MacAnalog/dn-002-tx-driver-pam4-ihp130/report/figs/round4/fig_balance.pdf

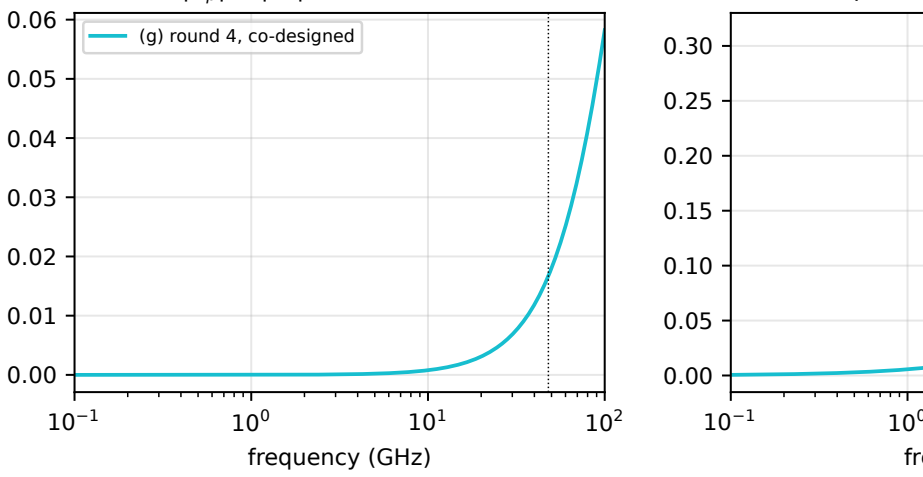
[picture p7: figure]
frequency (GHz); (g) round 4, co-designed

|Vp| − |Vn| (dB), MSB drive

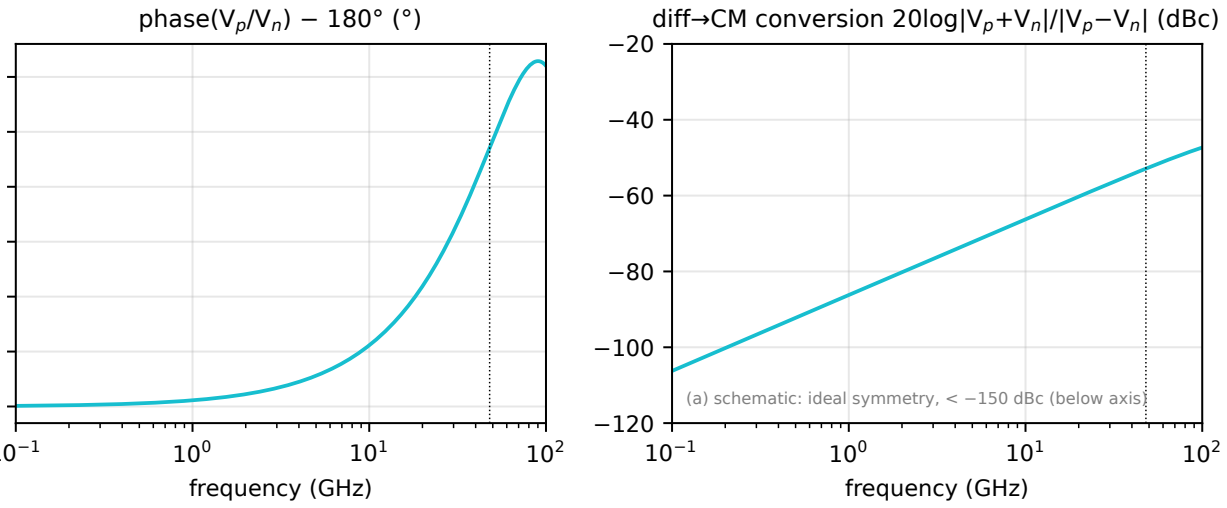
[picture p8: figure]
frequency (GHz); phase(Vp/Vn) − 180° (°); diff→CM conversion 20log|Vp+Vn|/|Vp−Vn| (dBc)

0 | 10
1 | 10
2
frequency (GHz)
(a) schematic: ideal symmetry, < −150 dBc (below axis)
