MacAnalog/dn-002-tx-driver-pam4-ihp130/report/figs/round4/fig_dc.pdf

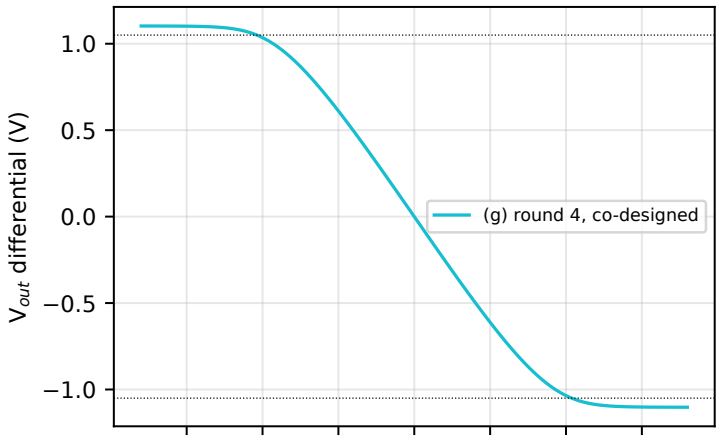
[picture p9: figure]
Vout differential (V); (g) round 4, co-designed

−0.75 −0.50 −0.25 0.00 0.25 0.50 0.75 differential source EMF, both ports (V)

DC transfer (swing spec ≥ 2.1 Vpp = ±1.05 V)
