MacAnalog/dn-002-tx-driver-pam4-ihp130/report/figs/round4/fig_layouts.pdf

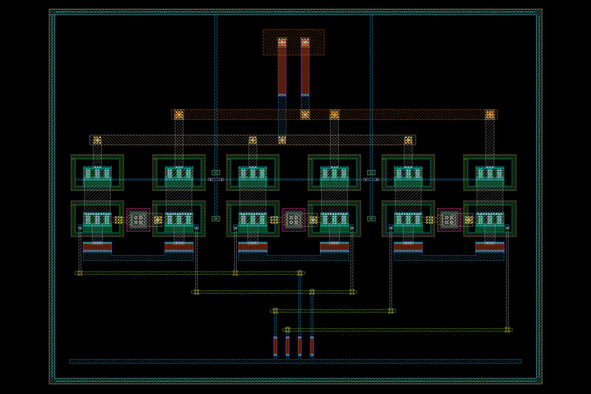
[picture p10: page 1]

−40 | −20 | 0 | 20 | 40
| | x (µm)

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
y (µm)

(g) co-design round 4 accepted point (r4_s10/run_29: reviewer-margin hinges + vcc_trim/rb_off options) 97.1 × 73.8 µm = 7166 µm² S11 -10.17 / S22 -10.25 dB 175 mW
