MacAnalog/dn-002-tx-driver-pam4-ihp130/layout/codesign/before_after_r4.pdf

−40 | −20 | 0 | 20 | 40
| | x (um)

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
## y (um)

## before: round-3 record (r3_s12 run_26, FINAL_LAYOUT), kpex halo 8

S11 -10.16 dB S22 -10.28 dB MSB 8.36 dB LSB 2.38 dB BW 61.1 GHz swing 2.11 Vpp 167 mW 7268 um2

−40 | −20 | 0 | 20 | 40
| | x (um)

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
## y (um)

moved knobs: gap_x 5.65->5.66, row_gap 1.91->1.96, cell_gap 4.21->4.12, re_ohm 3.09->3.24, rc_ohm 51.77->52.08, rb_ohm 48.32->48.01, cdeg_ff 16.84->17.24, re_w 5.66->5.56, rc_w 1.51->1.52, rb_w 0.68->0.64, w_out 1.68->1.61, in_off 2.18->2.16, in_bus_gap 3.26->3.12, sub_off 1.33->1.3, out_off 2.06->1.88, out_w 1.97->1.94, out_gap 3.18->3.05, in_bus_lvl 0->3, rc_sep 4.48->4.55, rc_gap 2.87->2.82, vcc_trim 0->1, rb_off 0->-9.23, stack_w 1.47->1.43

## after: round-4 accepted (r4_s10 run_29, R4_LAYOUT), kpex halo 8

S11 -10.24 dB S22 -10.25 dB MSB 8.37 dB LSB 2.39 dB BW 61.5 GHz swing 2.21 Vpp 175 mW 7166 um2

output buses: bus_trim 1->1, out_split 1->1, out_gap 3.18->3.05
