MacAnalog/dn-002-tx-driver-pam4-ihp130/report/figs/fig_layout_b_vs_d.pdf

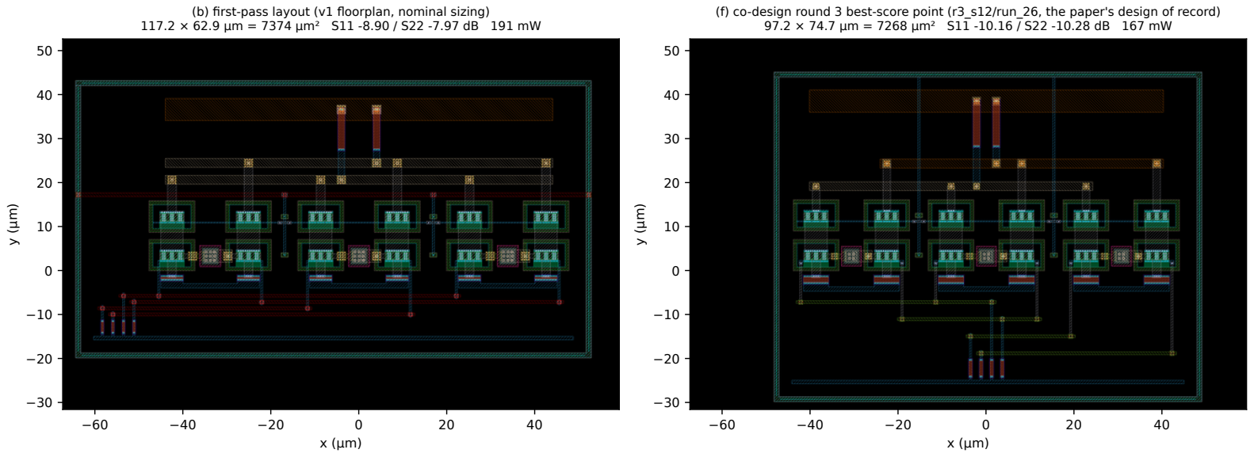
[picture p11: page 1]

−60 | −40 | −20 | 0 | 20 | 40
| | | x (µm)

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
y (µm)

(b) first-pass layout (v1 floorplan, nominal sizing)
117.2 × 62.9 µm = 7374 µm² S11 -8.90 / S22 -7.97 dB 191 mW
−60 | −40 | −20 | 0 | 20 | 40
| | | x (µm)

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
y (µm)

(f) co-design round 3 best-score point (r3_s12/run_26, the paper's design of record) 97.2 × 74.7 µm = 7268 µm² S11 -10.16 / S22 -10.28 dB 167 mW
