MacAnalog/dn-002-tx-driver-pam4-ihp130/report/figs/round4/fig_eye.pdf

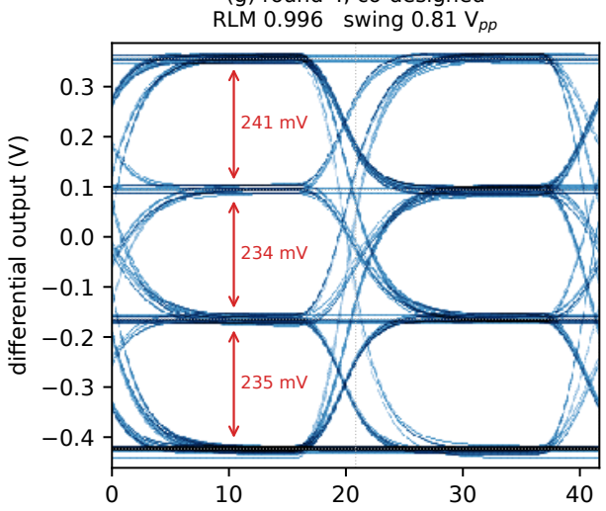
[picture p12: figure]
fferential output (V); RLM 0.996 swing 0.81 Vpp

time (ps) — 2 UI, eye centred at 0.5 UI

(g) round 4, co-designed

48 GBd PAM-4 eye — 200 mVpp input, 4 ps edges, seed-7 MSB/LSB streams; post-layout tiers on the kpex 2.5D CC extraction
