MacAnalog/dn-002-tx-driver-pam4-ihp130/report/figs/round4/fig_eye_paper.pdf

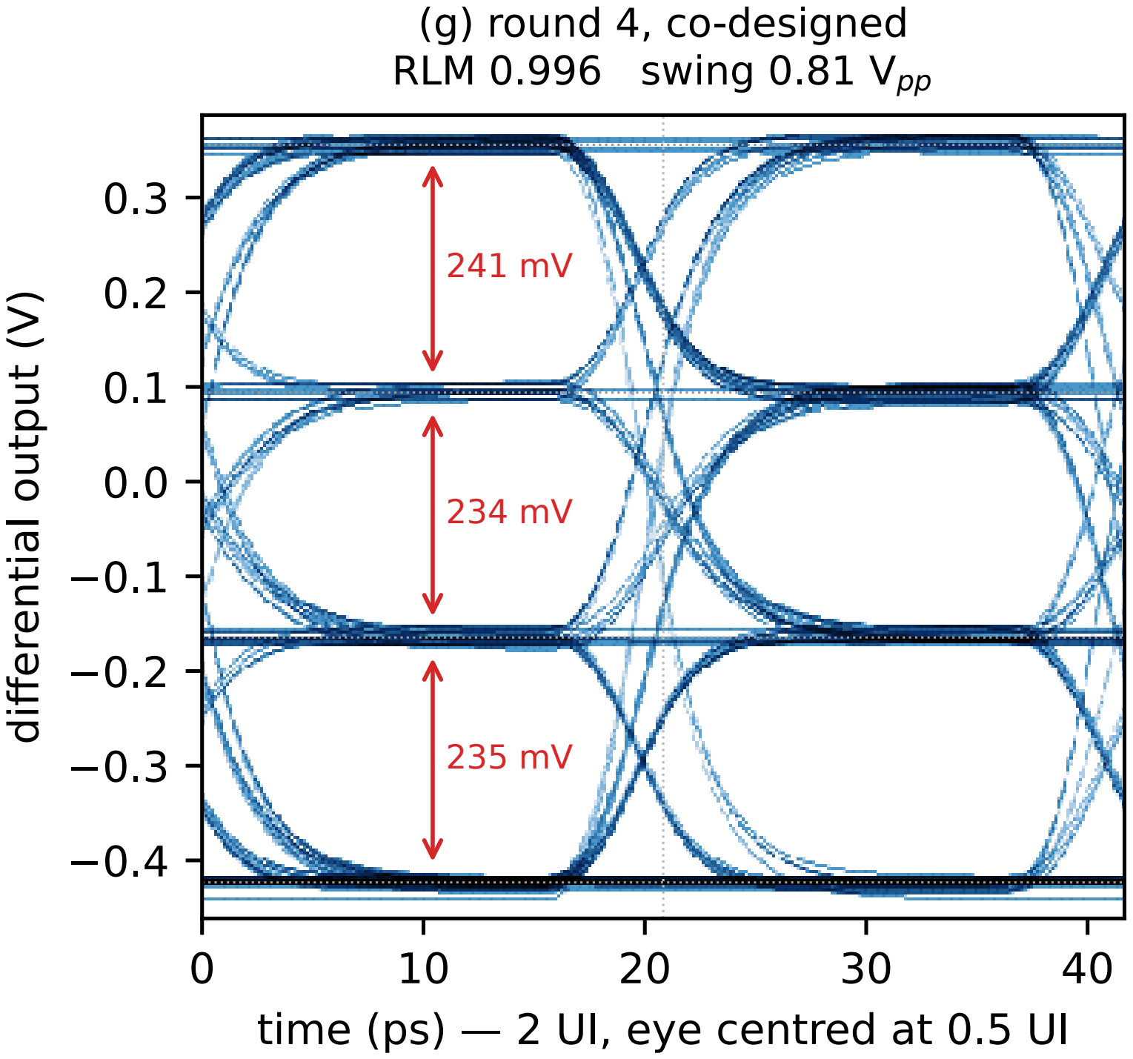
[picture p13: page 1]

0 | 10 | 20 | 30 | 40
time (ps) — 2 UI, eye centred at 0.5 UI

−0.4

−0.3

−0.2

−0.1

0.0

0.1

0.2

0.3

di

fferential output (V)

241 mV

234 mV

235 mV

(g) round 4, co-designed
RLM 0.996 swing 0.81 Vpp
