MacAnalog/dn-002-tx-driver-pam4-ihp130/report/figs/round4/fig_sparams.pdf

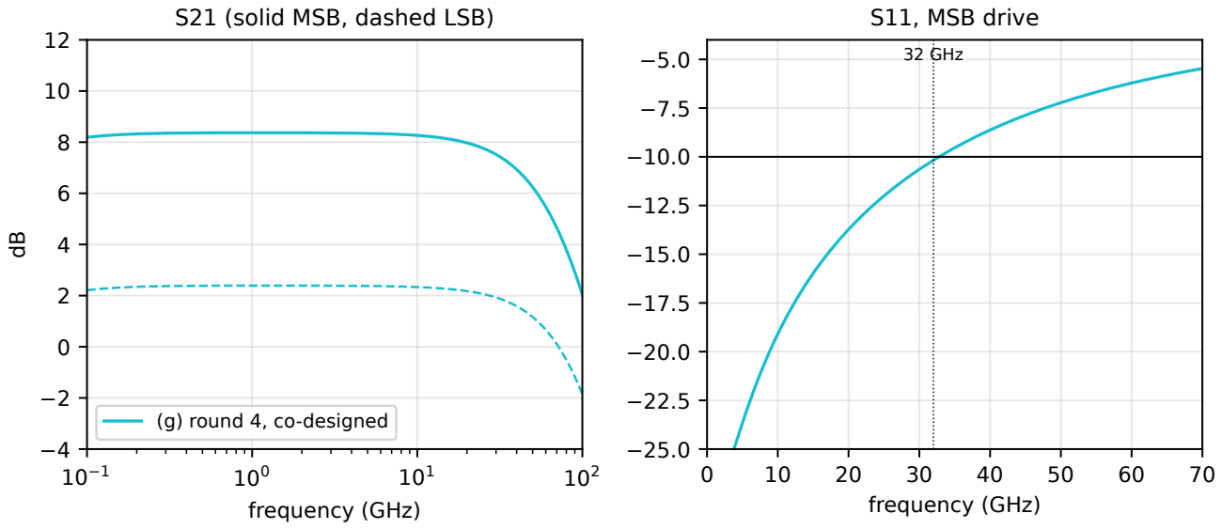
[picture p14: figure]
frequency (GHz); S21 (solid MSB, dashed LSB); (g) round 4, co-designed; 32 GHz; S11, MSB drive
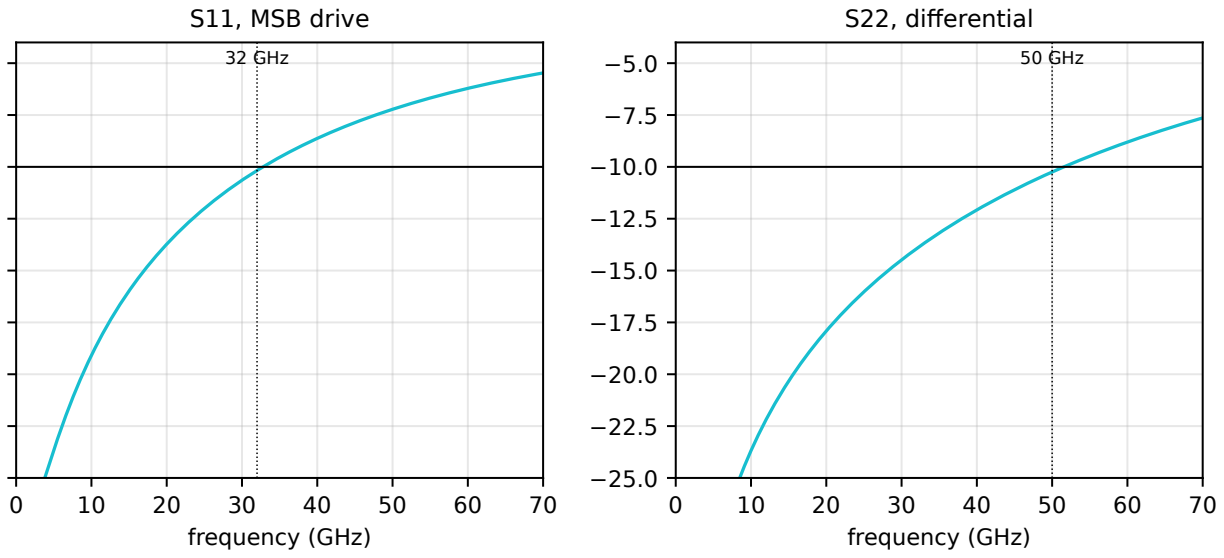
[picture p15: figure]
frequency (GHz); 50 GHz; S22, differential
