MacAnalog/dn-002-tx-driver-pam4-ihp130/layout/codesign/before_after_r4.png

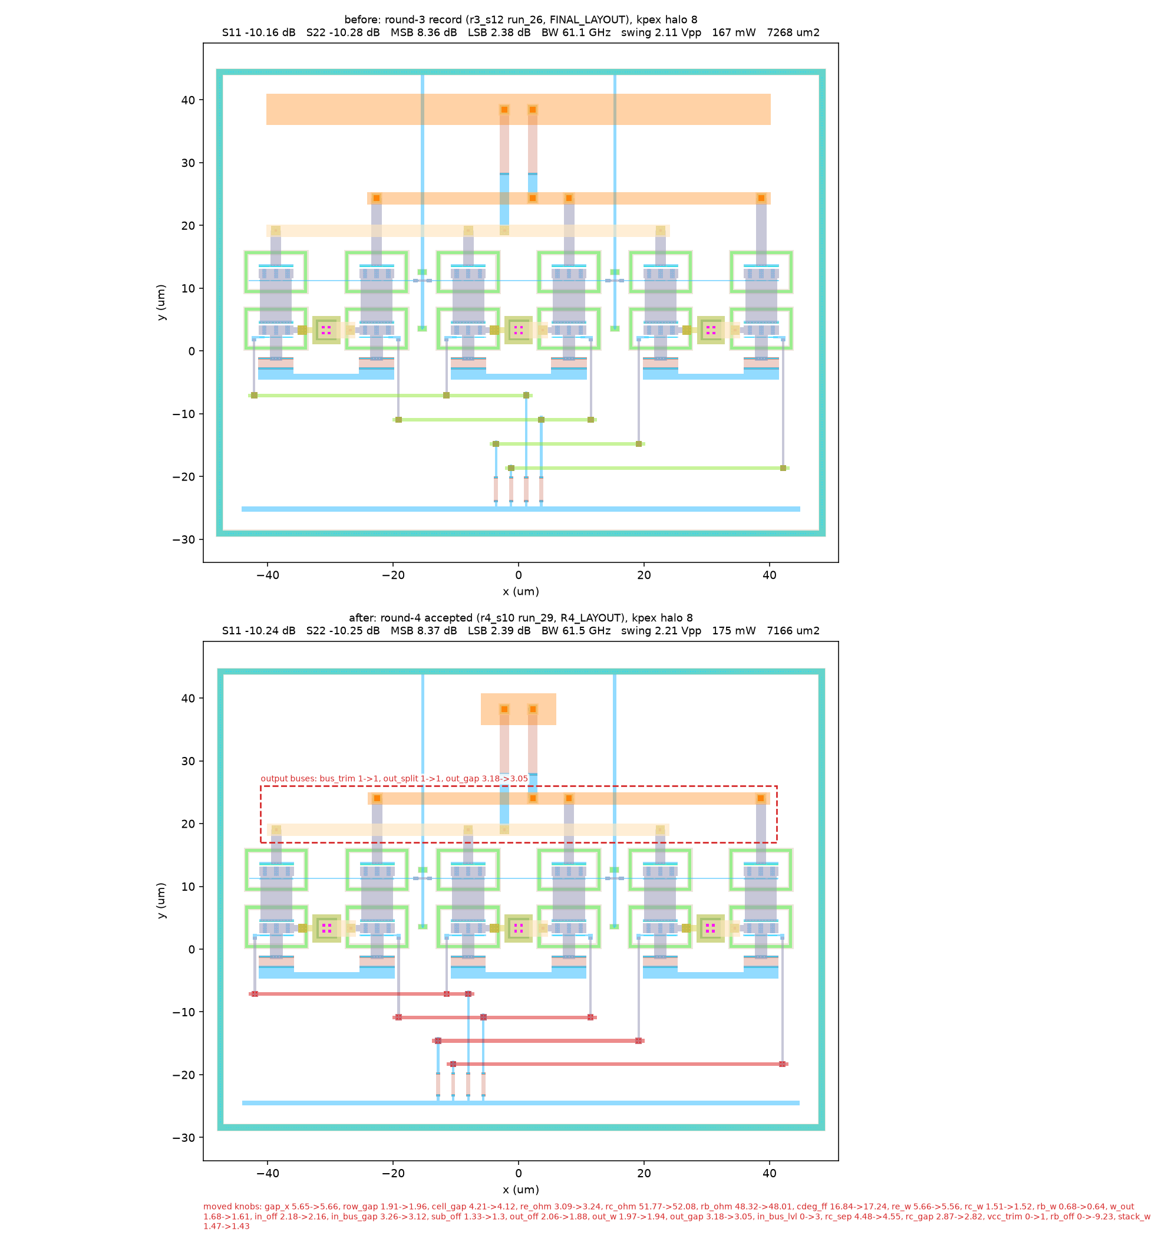
layout/codesign/before_after_r4.png
