MacAnalog/dn-002-tx-driver-pam4-ihp130/layout/codesign/pam4_layout_annotated_r4.png

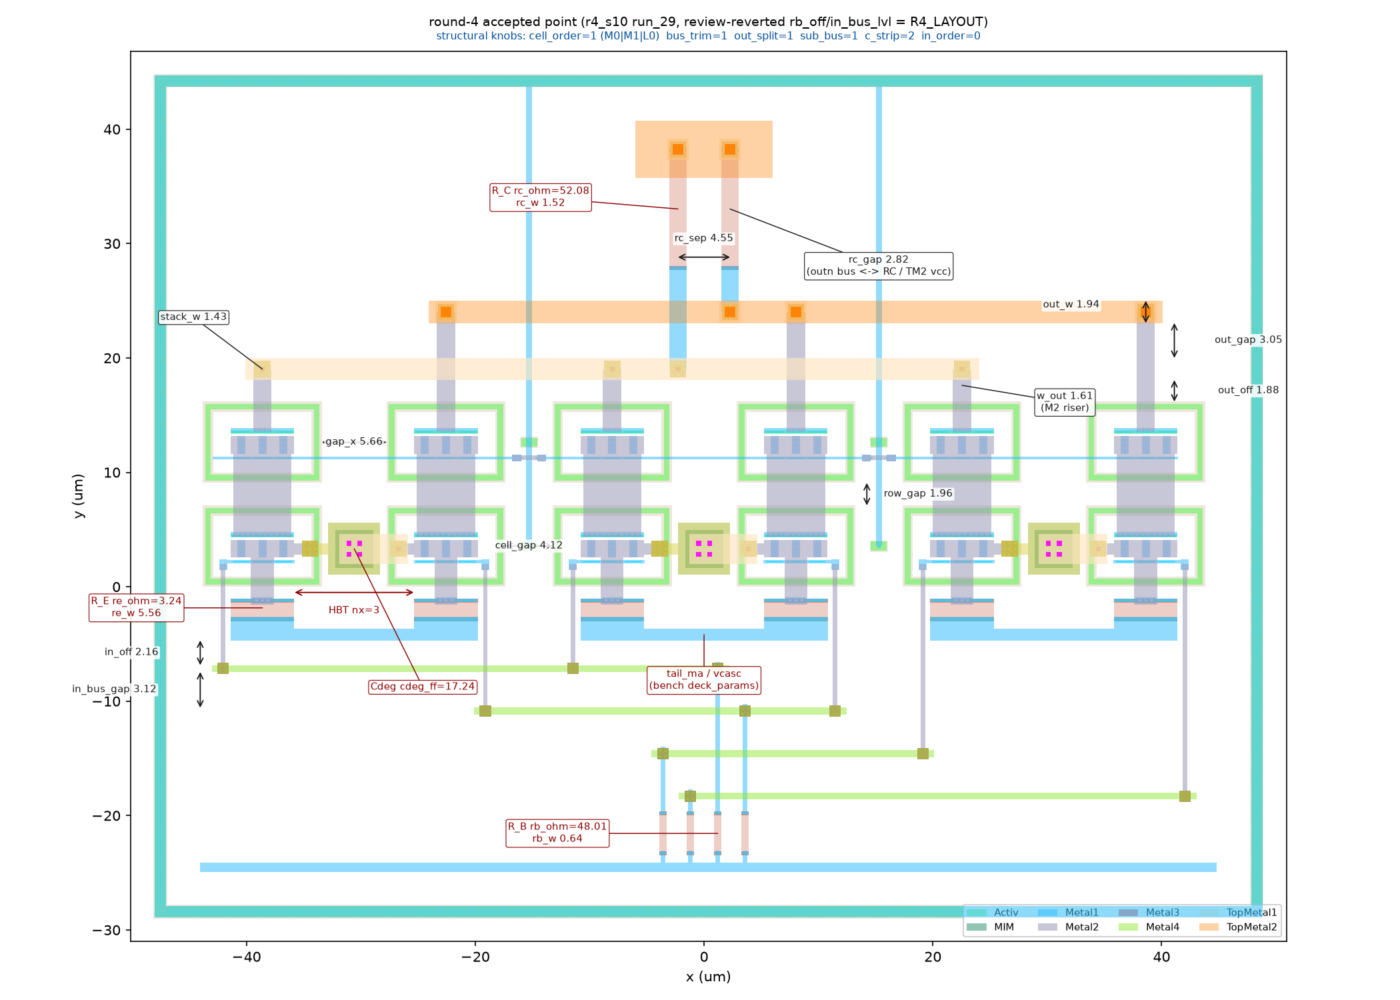
layout/codesign/pam4_layout_annotated_r4.png
