MacAnalog/dn-002-tx-driver-pam4-ihp130/report/figs/round4/fig_balance.png

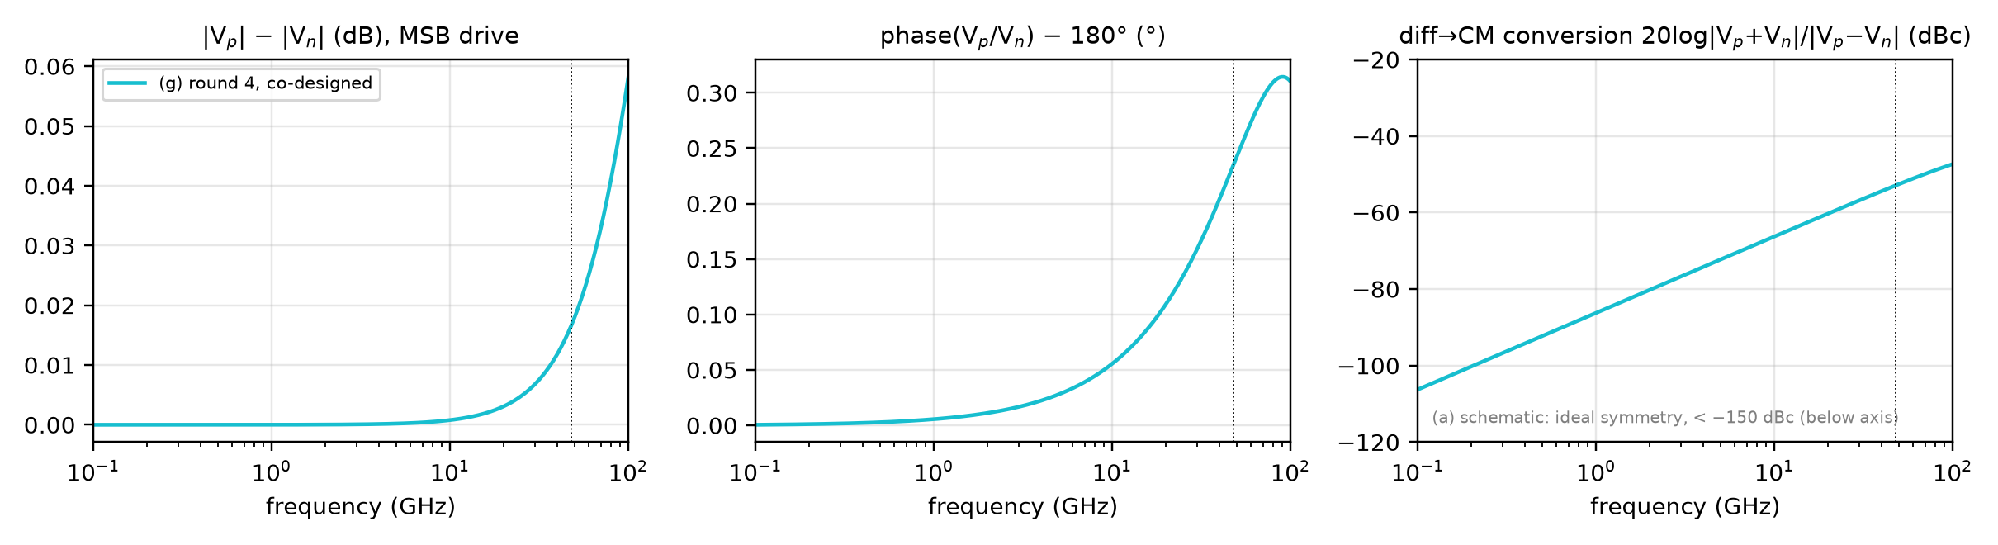
report/figs/round4/fig_balance.png
