MacAnalog/dn-002-tx-driver-pam4-ihp130/report/figs/round4/fig_layout_f_vs_g.png

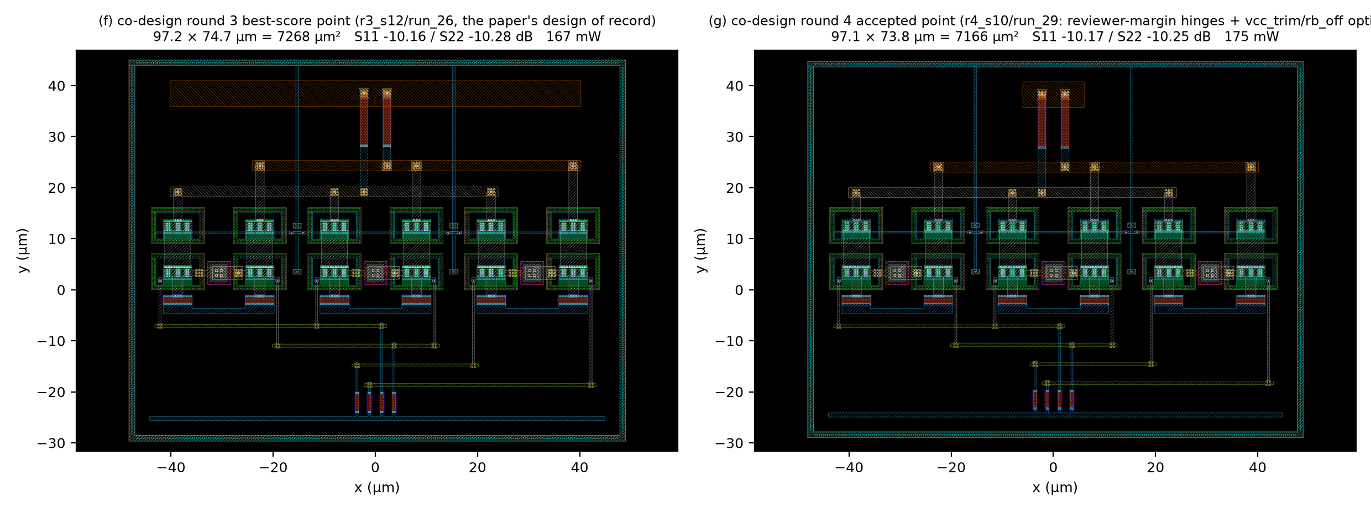
report/figs/round4/fig_layout_f_vs_g.png
