MacAnalog/dn-002-tx-driver-pam4-ihp130/layout/codesign/results/r4/verification.md

# Post-layout verification of the round-4 point (`R4_LAYOUT` = r4_s10/run_29 with `rb_off`/`in_bus_lvl` reverted)

Measured on the halo-8 extraction of the accepted point (`runs/rm_r4_rb0_lvl4`, the
report instrument; `accepted.gds` / `accepted_post.spice` / `accepted_summary.json` here
are that trial) with the reviewer-evidence harness (`~/sx-scratch/pam4-driver-reviewer-evidence/`
on the research server — NOT in this repo; its `config/pvt.yaml` + `config/mc.yaml` are the
corner grid / MC sets, `harness.py` wraps this repo's own `measure_post.measure` + `driver_lib`
with the platform's `apply_corner_to_deck`; it has to run with THIS repo's `.venv` (gdsfactory)
plus `dacite`; moving it into the repo is a follow-up for the owner). Same corner grid, MC
sets, seeds and instrument as the record's pack. The record's own sweep is the comparison
column; the search leader `run_29` as searched (before the review revert, see README
"Round 4") is kept as the middle column so the cost of the revert at the corners is visible.

## PVT — worst corner per spec, record vs run_29-as-searched vs round 4

/bin/bash: line 59: ../../.venv/bin/python: No such file or directory

## PVT — full tables (round 4)

Corners run: **36/36 converged**  (3 process x 3 VCC x 4 temperature, instrument = the record's own `layout/codesign/measure_post.measure`).

### Nominal cross-check (tt / 4.0 V / 27 C vs the paper's Round-3 column; `paper` = the record)

| metric | paper | this run | delta |
|---|---:|---:|---:|
| s11 (dB) | -10.157 | -10.18 | -0.01809 |
| s11_edge_ghz (GHz) | 32.71 | 32.79 | +0.08052 |
| s22 (dB) | -10.28 | -10.25 | +0.03344 |
| s22_edge_ghz (GHz) | 51.77 | 51.56 | -0.2112 |
| lsb_gain (dB) | 2.38 | 2.393 | +0.01303 |
| msb_gain (dB) | 8.36 | 8.37 | +0.009857 |
| bw (GHz) | 61.1 | 61.28 | +0.1821 |
| swing (Vpp) | 2.106 | 2.205 | +0.09921 |
| power (mW) | 167.164 | 175 | +7.847 |
| pn_gain_imb_db (dB) | 0.0167 | 0.0166 | -9.764e-05 |
| pn_phase_imb_deg (deg) | 0.2425 | 0.247 | +0.004494 |
| cm_leak_dbc (dBc) | -52.65 | -52.53 | +0.1231 |

Every printed metric reproduces; the harness measures the same thing the paper does.

### Worst corner per spec

| metric | spec | worst value | worst corner | margin | verdict |
|---|---:|---:|---|---:|:--|
| s11 | <= -10 dB | -8.735 | `ss_3.8V_125C` | -1.27 | **FAIL** |
| s22 | <= -10 dB | -6.372 | `ss_3.8V_125C` | -3.63 | **FAIL** |
| pn_gain_imb_db | <= 0.05 dB | 0.02686 | `ss_3.8V_125C` | +0.0231 | PASS |
| pn_phase_imb_deg | <= 1 deg | 0.2718 | `tt_4.2V_125C` | +0.728 | PASS |
| cm_leak_dbc | <= -40 dBc | -51.29 | `ss_4.2V_125C` | +11.3 | PASS |
| power | <= 192 mW | 184.4 | `ff_4.2V_-40C` | +7.62 | PASS |
| ic_ma_per_finger | <= 3 mA | 2.442 | `tt_3.8V_-40C` | +0.558 | PASS |
| msb_gain | >= 8.2 dB | 6.458 | `ss_4.2V_-40C` | -1.74 | **FAIL** |
| lsb_gain | >= 2.2 dB | 0.4735 | `ss_4.2V_-40C` | -1.73 | **FAIL** |
| weight | >= 5 dB | 5.9 | `ss_4.2V_125C` | +0.9 | PASS |
| bw | >= 50 GHz | 44.04 | `ss_3.8V_125C` | -5.96 | **FAIL** |
| swing | >= 2.1 Vpp | 1.83 | `ff_3.8V_-40C` | -0.27 | **FAIL** |

**6/36 corners meet every spec.**

**7 corners have an INCOMPLETE DC sweep** — ngspice stopped the sweep at a non-converging point and the bench accepted the partial file, so their `swing` is a measurement artifact, not a design failure, and is excluded from the verdicts above:

| corner | sweep points | expected | reported swing (invalid) |
|---|---:|---:|---:|
| `ff_3.8V_85C` | 21 | 121 | 0.009147 |
| `ff_3.8V_125C` | 58 | 121 | 0.9892 |
| `ff_4V_125C` | 38 | 121 | 0.2468 |
| `ff_4.2V_85C` | 44 | 121 | 0.4138 |
| `ff_4.2V_125C` | 62 | 121 | 1.226 |
| `ss_3.8V_125C` | 117 | 121 | 2.209 |
| `ss_4.2V_85C` | 94 | 121 | 2.319 |

Corners that violate at least one spec:

| corner | s11 | s22 | pn_gain_imb_db | pn_phase_imb_deg | cm_leak_dbc | power | ic_ma_per_finger | msb_gain | lsb_gain | weight | bw | swing |
|---|---:|---:|---:|---:|---:|---:|---:|---:|---:|---:|---:|---:|
| `tt_3.8V_-40C` | -10.19 | -10.78 | 0.01331 | 0.2211 | -53.63 | 166.6 | 2.442 | **6.841** | **0.8432** | 5.998 | 71.18 | **1.96** |
| `tt_3.8V_85C` | **-9.644** | **-8.694** | 0.02026 | 0.2572 | -51.92 | 165.9 | 2.442 | 9.172 | 3.213 | 5.958 | 54.32 | 2.23 |
| `tt_3.8V_125C` | **-9.194** | **-7.554** | 0.02306 | 0.2573 | -51.65 | 165.7 | 2.442 | 9.538 | 3.592 | 5.946 | 50.08 | 2.241 |
| `tt_4V_-40C` | -10.19 | -10.89 | 0.01317 | 0.2217 | -53.63 | 175.4 | 2.442 | **6.84** | **0.8419** | 5.998 | 71.5 | **1.969** |
| `tt_4V_85C` | **-9.654** | **-9.109** | 0.01949 | 0.262 | -51.86 | 174.7 | 2.442 | 9.169 | 3.211 | 5.958 | 55.29 | 2.359 |
| `tt_4V_125C` | **-9.218** | **-8.222** | 0.02162 | 0.268 | -51.51 | 174.4 | 2.442 | 9.536 | 3.59 | 5.946 | 51.89 | 2.422 |
| `tt_4.2V_-40C` | -10.19 | -10.96 | 0.01307 | 0.2221 | -53.62 | 184.2 | 2.442 | **6.838** | **0.8406** | 5.998 | 71.74 | **1.969** |
| `tt_4.2V_85C` | **-9.657** | **-9.278** | 0.01918 | 0.2638 | -51.84 | 183.4 | 2.442 | 9.167 | 3.209 | 5.958 | 55.66 | 2.381 |
| `tt_4.2V_125C` | **-9.227** | **-8.498** | 0.02103 | 0.2718 | -51.47 | 183.1 | 2.442 | 9.533 | 3.587 | 5.946 | 52.52 | 2.477 |
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

## Mismatch Monte Carlo

### Where each spread comes from

`pair_only` mismatches the six differential-pair HBTs; `all_devices` adds the resistors and capacitors. Same seeds, same count, so the ratio of sigmas attributes each spread.

| metric | sigma, pair only | sigma, all devices | ratio | dominated by |
|---|---:|---:|---:|---|
| offset_mv (mV) | 33.5 | 33.6 | 1.00x | the differential pair |
| pn_gain_imb_db (dB) | 0.00287 | 0.0265 | 9.22x | the passives (R / C) |
| pn_phase_imb_deg (deg) | 0.167 | 0.377 | 2.26x | both, comparably |
| cm_leak_dbc (dBc) | 4.1 | 6.77 | 1.65x | both, comparably |
| msb_gain (dB) | 0.246 | 0.247 | 1.01x | the differential pair |
| lsb_gain (dB) | 0.358 | 0.359 | 1.00x | the differential pair |
| swing (Vpp) | 0.000447 | 0.00348 | 7.77x | the passives (R / C) |
| power (mW) | 0.012 | 0.0171 | 1.43x | both, comparably |
| bw (GHz) | 1.05 | 1.1 | 1.05x | the differential pair |
| s11 (dB) | 0.247 | 0.249 | 1.01x | the differential pair |
| s22 (dB) | 0.0104 | 0.17 | 16.32x | the passives (R / C) |

### `all_devices` — 200/200 samples converged

| metric | nominal | mean | sigma | min | max | 3-sigma band |
|---|---:|---:|---:|---:|---:|---|
| offset_mv (mV) | -0.0002166 | 0.6847 | 33.6 | -86.99 | 121.1 | -100 .. 101.4 |
| pn_gain_imb_db (dB) | 0.0166 | 0.03912 | 0.0265 | 0.001203 | 0.1417 | -0.04023 .. 0.1185 |
| pn_phase_imb_deg (deg) | 0.247 | 0.4702 | 0.377 | 0.006405 | 2 | -0.6621 .. 1.602 |
| cm_leak_dbc (dBc) | -52.53 | -48.54 | 6.77 | -66.87 | -34.28 | -68.85 .. -28.22 |
| msb_gain (dB) | 8.37 | 8.331 | 0.247 | 7.684 | 8.924 | 7.589 .. 9.074 |
| lsb_gain (dB) | 2.393 | 2.37 | 0.359 | 1.474 | 3.291 | 1.293 .. 3.446 |
| swing (Vpp) | 2.205 | 2.205 | 0.00348 | 2.196 | 2.213 | 2.194 .. 2.215 |
| power (mW) | 175 | 175 | 0.0171 | 175 | 175 | 175 .. 175.1 |
| bw (GHz) | 61.28 | 61.31 | 1.1 | 58.49 | 63.82 | 58 .. 64.61 |
| s11 (dB) | -10.18 | -10.19 | 0.249 | -10.83 | -9.601 | -10.94 .. -9.442 |
| s22 (dB) | -10.25 | -10.24 | 0.17 | -10.83 | -9.817 | -10.75 .. -9.733 |
Samples outside the acceptance box:

| metric | spec | samples failing | rate |
|---|---:|---:|---:|
| s11 | <= -10 dB | 48/200 | 24.0 % |
| s22 | <= -10 dB | 18/200 | 9.0 % |
| pn_gain_imb_db | <= 0.05 dB | 56/200 | 28.0 % |
| pn_phase_imb_deg | <= 1 deg | 23/200 | 11.5 % |
| cm_leak_dbc | <= -40 dBc | 16/200 | 8.0 % |
| msb_gain | >= 8.2 dB | 58/200 | 29.0 % |
| lsb_gain | >= 2.2 dB | 66/200 | 33.0 % |

### `pair_only` — 200/200 samples converged

| metric | nominal | mean | sigma | min | max | 3-sigma band |
|---|---:|---:|---:|---:|---:|---|
| offset_mv (mV) | -0.0002166 | 0.8597 | 33.5 | -85.98 | 119.9 | -99.58 .. 101.3 |
| pn_gain_imb_db (dB) | 0.0166 | 0.01646 | 0.00287 | 0.009488 | 0.02425 | 0.007853 .. 0.02507 |
| pn_phase_imb_deg (deg) | 0.247 | 0.2739 | 0.167 | 0.0135 | 0.8949 | -0.2276 .. 0.7753 |
| cm_leak_dbc (dBc) | -52.53 | -52.38 | 4.1 | -60.89 | -42.1 | -64.68 .. -40.08 |
| msb_gain (dB) | 8.37 | 8.33 | 0.246 | 7.675 | 8.933 | 7.594 .. 9.067 |
| lsb_gain (dB) | 2.393 | 2.369 | 0.358 | 1.449 | 3.293 | 1.293 .. 3.444 |
| swing (Vpp) | 2.205 | 2.205 | 0.000447 | 2.204 | 2.206 | 2.204 .. 2.206 |
| power (mW) | 175 | 175 | 0.012 | 175 | 175 | 175 .. 175 |
| bw (GHz) | 61.28 | 61.35 | 1.05 | 58.63 | 64.04 | 58.2 .. 64.5 |
| s11 (dB) | -10.18 | -10.19 | 0.247 | -10.85 | -9.571 | -10.93 .. -9.453 |
| s22 (dB) | -10.25 | -10.25 | 0.0104 | -10.27 | -10.22 | -10.28 .. -10.21 |
Samples outside the acceptance box:

| metric | spec | samples failing | rate |
|---|---:|---:|---:|
| s11 | <= -10 dB | 45/200 | 22.5 % |
| msb_gain | >= 8.2 dB | 58/200 | 29.0 % |
| lsb_gain | >= 2.2 dB | 69/200 | 34.5 % |

## Figures

* `fig_pvt_r4.png`
* `fig_mc_r4.png`
