MacAnalog/dn-002-tx-driver-pam4-ihp130/verification/decks/a/balance.csv

 1.00000000e+08  2.86729686e+00  1.00000000e+08  2.86729686e+00  1.00000000e+08 -1.76785149e+02  1.00000000e+08  3.21485093e+00  1.00000000e+08 -2.96802909e+02  1.00000000e+08  8.88789678e+00  1.00000000e+08 -2.90438694e+02
 1.02329299e+08  2.87437874e+00  1.02329299e+08  2.87437874e+00  1.02329299e+08 -1.76848435e+02  1.02329299e+08  3.15156536e+00  1.02329299e+08 -2.91130325e+02  1.02329299e+08  8.89497865e+00  1.02329299e+08 -2.97400075e+02
 1.04712855e+08  2.88120645e+00  1.04712855e+08  2.88120645e+00  1.04712855e+08 -1.76911333e+02  1.04712855e+08  3.08866673e+00  1.04712855e+08 -2.91129816e+02  1.04712855e+08  8.90180636e+00  1.04712855e+08 -2.89253578e+02
 1.07151931e+08  2.88778659e+00  1.07151931e+08  2.88778659e+00  1.07151931e+08 -1.76973810e+02  1.07151931e+08  3.02619046e+00  1.07151931e+08 -2.88717481e+02  1.07151931e+08  8.90838650e+00  1.07151931e+08 -2.94905066e+02
 1.09647820e+08  2.89412578e+00  1.09647820e+08  2.89412578e+00  1.09647820e+08 -1.77035831e+02  1.09647820e+08  2.96416917e+00  1.09647820e+08 -2.91846945e+02  1.09647820e+08  8.91472569e+00  1.09647820e+08 -2.97501078e+02
 1.12201845e+08  2.90023065e+00  1.12201845e+08  2.90023065e+00  1.12201845e+08 -1.77097367e+02  1.12201845e+08  2.90263276e+00  1.12201845e+08 -2.96802909e+02  1.12201845e+08  8.92083057e+00  1.12201845e+08 -2.95003067e+02
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
 9.54992586e+10 -2.08799731e+00  9.54992586e+10 -2.08799731e+00  9.54992586e+10  8.04898300e+01  9.54992586e+10 -9.95101700e+01  9.54992586e+10 -2.90285841e+02  9.54992586e+10  3.93260261e+00  9.54992586e+10 -2.93908467e+02
 9.77237221e+10 -2.25430367e+00  9.77237221e+10 -2.25430367e+00  9.77237221e+10  7.88174329e+01  9.77237221e+10 -1.01182567e+02  9.77237221e+10 -2.90457183e+02  9.77237221e+10  3.76629624e+00  9.77237221e+10 -2.94947387e+02
 1.00000000e+11 -2.42446290e+00  1.00000000e+11 -2.42446290e+00  1.00000000e+11  7.71300197e+01  1.00000000e+11 -1.02869980e+02  1.00000000e+11 -2.93850282e+02  1.00000000e+11  3.59613702e+00  1.00000000e+11 -2.96325352e+02
