MacAnalog/dn-002-tx-driver-pam4-ihp130/verification/decks/b/balance.csv

 1.00000000e+08  2.72594856e+00  1.00000000e+08  2.72594973e+00  1.00000000e+08 -1.76832032e+02  1.00000000e+08  3.16741874e+00  1.00000000e+08 -9.76378298e+01  1.00000000e+08  8.74654906e+00  1.00000000e+08 -8.21802705e+01
 1.02329299e+08  2.73302921e+00  1.02329299e+08  2.73303038e+00  1.02329299e+08 -1.76896375e+02  1.02329299e+08  3.10306227e+00  1.02329299e+08 -9.74291019e+01  1.02329299e+08  8.75362971e+00  1.02329299e+08 -8.19732113e+01
 1.04712855e+08  2.73985573e+00  1.04712855e+08  2.73985691e+00  1.04712855e+08 -1.76960357e+02  1.04712855e+08  3.03906710e+00  1.04712855e+08 -9.72206903e+01  1.04712855e+08  8.76045623e+00  1.04712855e+08 -8.17664054e+01
 1.07151931e+08  2.74643472e+00  1.07151931e+08  2.74643590e+00  1.07151931e+08 -1.77023943e+02  1.07151931e+08  2.97546806e+00  1.07151931e+08 -9.70125868e+01  1.07151931e+08  8.76703522e+00  1.07151931e+08 -8.15598462e+01
 1.09647820e+08  2.75277278e+00  1.09647820e+08  2.75277396e+00  1.09647820e+08 -1.77087100e+02  1.09647820e+08  2.91229717e+00  1.09647820e+08 -9.68047827e+01  1.09647820e+08  8.77337329e+00  1.09647820e+08 -8.13535271e+01
 1.12201845e+08  2.75887657e+00  1.12201845e+08  2.75887774e+00  1.12201845e+08 -1.77149799e+02  1.12201845e+08  2.84958372e+00  1.12201845e+08 -9.65972696e+01  1.12201845e+08  8.77947707e+00  1.12201845e+08 -8.11474415e+01
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
 9.54992586e+10 -4.66529419e+00  9.54992586e+10 -4.72035471e+00  9.54992586e+10  4.98556879e+01  9.54992586e+10 -1.30499884e+02  9.54992586e+10 -4.57332393e+01  9.54992586e+10  1.32777728e+00  9.54992586e+10 -2.94902153e+01
 9.77237221e+10 -4.90031314e+00  9.77237221e+10 -4.95734528e+00  9.77237221e+10  4.78067676e+01  9.77237221e+10 -1.32551150e+02  9.77237221e+10 -4.57834773e+01  9.77237221e+10  1.09177514e+00  9.77237221e+10 -2.95193294e+01
 1.00000000e+11 -5.14015757e+00  1.00000000e+11 -5.19920898e+00  1.00000000e+11  4.57442804e+01  1.00000000e+11 -1.34615789e+02  1.00000000e+11 -4.58391744e+01  1.00000000e+11  8.50923939e-01  1.00000000e+11 -2.95539523e+01
