MacAnalog/dn-002-tx-driver-pam4-ihp130/verification/decks/b/dc.csv

-9.00000000e-01  1.17806969e+00 -9.00000000e-01 -4.73868013e-02
-8.85000000e-01  1.17803872e+00 -8.85000000e-01 -4.73865752e-02
-8.70000000e-01  1.17800006e+00 -8.70000000e-01 -4.73863607e-02
-8.55000000e-01  1.17795128e+00 -8.55000000e-01 -4.73861613e-02
-8.40000000e-01  1.17788922e+00 -8.40000000e-01 -4.73859820e-02
-8.25000000e-01  1.17780971e+00 -8.25000000e-01 -4.73858288e-02
-8.10000000e-01  1.17770727e+00 -8.10000000e-01 -4.73857098e-02
-7.95000000e-01  1.17757474e+00 -7.95000000e-01 -4.73856362e-02
-7.80000000e-01  1.17740275e+00 -7.80000000e-01 -4.73856217e-02
-7.65000000e-01  1.17717905e+00 -7.65000000e-01 -4.73856846e-02
-7.50000000e-01  1.17688764e+00 -7.50000000e-01 -4.73858488e-02
-7.35000000e-01  1.17650775e+00 -7.35000000e-01 -4.73861452e-02
-7.20000000e-01  1.17601242e+00 -7.20000000e-01 -4.73866135e-02
-7.05000000e-01  1.17536692e+00 -7.05000000e-01 -4.73873047e-02
-6.90000000e-01  1.17452669e+00 -6.90000000e-01 -4.73882840e-02
-6.75000000e-01  1.17343506e+00 -6.75000000e-01 -4.73896332e-02
-6.60000000e-01  1.17202071e+00 -6.60000000e-01 -4.73914540e-02
-6.45000000e-01  1.17019511e+00 -6.45000000e-01 -4.73938704e-02
-6.30000000e-01  1.16785018e+00 -6.30000000e-01 -4.73970302e-02
-6.15000000e-01  1.16485692e+00 -6.15000000e-01 -4.74011040e-02
-6.00000000e-01  1.16106553e+00 -6.00000000e-01 -4.74062808e-02
-5.85000000e-01  1.15630804e+00 -5.85000000e-01 -4.74127586e-02
-5.70000000e-01  1.15040394e+00 -5.70000000e-01 -4.74207296e-02
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
 8.55000000e-01 -1.17795128e+00  8.55000000e-01 -4.73861613e-02
 8.70000000e-01 -1.17800006e+00  8.70000000e-01 -4.73863607e-02
 8.85000000e-01 -1.17803872e+00  8.85000000e-01 -4.73865752e-02
 9.00000000e-01 -1.17806969e+00  9.00000000e-01 -4.73868013e-02
