MacAnalog/dn-002-tx-driver-pam4-ihp130/verification/decks/b/eye.csv

 5.20833000e-15  6.16589867e-05
 1.04166600e-14  1.17542532e-04
 2.08333200e-14  2.21725953e-04
 4.16666400e-14  4.02479019e-04
 8.33332800e-14  7.08490752e-04
 1.66666560e-13  1.16172093e-03
 3.33333120e-13  1.62884905e-03
 5.20833000e-13  1.75385115e-03
 5.52358728e-13  1.75050024e-03
 6.15410183e-13  1.73870649e-03
 7.41513093e-13  1.69262323e-03
 9.93718913e-13  1.55557443e-03
 1.49813055e-12  1.23333668e-03
 2.01896355e-12  9.23730229e-04
 2.53979655e-12  6.84339734e-04
 3.06062955e-12  5.08191559e-04
 3.58146255e-12  3.77826904e-04
 4.10229555e-12  2.82685717e-04
 4.62312855e-12  2.12846840e-04
 5.14396155e-12  1.61996412e-04
 5.66479455e-12  1.24815628e-04
 6.18562755e-12  9.78187365e-05
 6.70646055e-12  7.81342388e-05
 7.22729355e-12  6.38853128e-05
 7.74812655e-12  5.35189361e-05
 8.26895955e-12  4.60444387e-05
 8.78979255e-12  4.06175845e-05
 9.31062555e-12  3.67245974e-05
 9.83145855e-12  3.39032814e-05
 1.03522916e-11  3.18938211e-05
 1.08731246e-11  3.04396528e-05
 1.13939576e-11  2.94147661e-05
 1.19147906e-11  2.86734213e-05
 1.24356236e-11  2.81591856e-05
 1.29564566e-11  2.77863397e-05
 1.34772896e-11  2.75339655e-05
 1.39981226e-11  2.73491804e-05
 1.45189556e-11  2.72286722e-05
 1.50397886e-11  2.71378401e-05
 1.55606216e-11  2.70816639e-05
 1.60814546e-11  2.70360009e-05
 1.66022876e-11  2.70093524e-05
 1.71231206e-11  2.69837931e-05
 1.76439536e-11  2.69689583e-05
 1.81647866e-11  2.69508064e-05
 1.86856196e-11  2.69389588e-05
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
 1.92805940e-09  2.48543356e-04
 1.92858023e-09  2.50235481e-04
 1.92910106e-09  2.51938905e-04
 1.92962190e-09  2.53653696e-04
 1.93014273e-09  2.55379921e-04
 1.93066356e-09  2.57117647e-04
 1.93118440e-09  2.58866944e-04
 1.93170523e-09  2.60627879e-04
 1.93222606e-09  2.62400521e-04
 1.93274689e-09  2.64184940e-04
 1.93326773e-09  2.65981204e-04
 1.93378856e-09  2.67789383e-04
 1.93430939e-09  2.69609547e-04
 1.93483023e-09  2.71441766e-04
 1.93535106e-09  2.73286110e-04
 1.93587189e-09  2.75142651e-04
 1.93639273e-09  2.77011460e-04
 1.93691356e-09  2.78892607e-04
 1.93743439e-09  2.80786164e-04
 1.93795522e-09  2.82692203e-04
 1.93847606e-09  2.84610797e-04
 1.93899689e-09  2.86542018e-04
 1.93951772e-09  2.88485938e-04
 1.94003856e-09  2.90442631e-04
 1.94055939e-09  2.92412170e-04
 1.94108022e-09  2.94394629e-04
 1.94160106e-09  2.96390080e-04
 1.94212189e-09  2.98398600e-04
 1.94264272e-09  3.00420261e-04
 1.94316355e-09  3.02455140e-04
 1.94368439e-09  3.04503310e-04
 1.94420522e-09  3.06564847e-04
 1.94472605e-09  3.08639826e-04
 1.94524689e-09  3.10728324e-04
 1.94576772e-09  3.12830417e-04
 1.94628855e-09  3.14946180e-04
 1.94680939e-09  3.17075691e-04
 1.94733022e-09  3.19219026e-04
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
