MacAnalog/dn-002-tx-driver-pam4-ihp130/verification/decks/c/balance.csv

 1.00000000e+08  2.05098173e+00  1.00000000e+08  2.05098264e+00  1.00000000e+08 -1.76716967e+02  1.00000000e+08  3.28186236e+00  1.00000000e+08 -9.17393239e+01  1.00000000e+08  8.07158210e+00  1.00000000e+08 -1.02669933e+02
 1.02329299e+08  2.05826796e+00  1.02329299e+08  2.05826887e+00  1.02329299e+08 -1.76782570e+02  1.02329299e+08  3.21623158e+00  1.02329299e+08 -9.15313839e+01  1.02329299e+08  8.07886833e+00  1.02329299e+08 -1.02462966e+02
 1.04712855e+08  2.06529281e+00  1.04712855e+08  2.06529371e+00  1.04712855e+08 -1.76847789e+02  1.04712855e+08  3.15098413e+00  1.04712855e+08 -9.13237299e+01  1.04712855e+08  8.08589317e+00  1.04712855e+08 -1.02256248e+02
 1.07151931e+08  2.07206302e+00  1.07151931e+08  2.07206393e+00  1.07151931e+08 -1.76912589e+02  1.07151931e+08  3.08615621e+00  1.07151931e+08 -9.11163544e+01  1.07151931e+08  8.09266339e+00  1.07151931e+08 -1.02049773e+02
 1.09647820e+08  2.07858542e+00  1.09647820e+08  2.07858632e+00  1.09647820e+08 -1.76976934e+02  1.09647820e+08  3.02178108e+00  1.09647820e+08 -9.09092498e+01  1.09647820e+08  8.09918578e+00  1.09647820e+08 -1.01843534e+02
 1.12201845e+08  2.08486682e+00  1.12201845e+08  2.08486772e+00  1.12201845e+08 -1.77040796e+02  1.12201845e+08  2.95788922e+00  1.12201845e+08 -9.07024087e+01  1.12201845e+08  8.10546718e+00  1.12201845e+08 -1.01637525e+02
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
 1.77827941e+08  2.16988979e+00  1.77827941e+08  2.16989047e+00  1.77827941e+08 -1.78190161e+02  1.77827941e+08  1.80775408e+00  1.77827941e+08 -8.66098983e+01  1.77827941e+08  8.19049004e+00  1.77827941e+08 -9.75561496e+01
 1.81970086e+08  2.17256519e+00  1.81970086e+08  2.17256585e+00  1.81970086e+08 -1.78240755e+02  1.81970086e+08  1.75711174e+00  1.81970086e+08 -8.64069900e+01  1.81970086e+08  8.19316543e+00  1.81970086e+08 -9.73535876e+01
 1.86208714e+08  2.17512833e+00  1.86208714e+08  2.17512897e+00  1.86208714e+08 -1.78290709e+02  1.86208714e+08  1.70710773e+00  1.86208714e+08 -8.62042039e+01  1.86208714e+08  8.19572856e+00  1.86208714e+08 -9.71511330e+01
 1.90546072e+08  2.17758356e+00  1.90546072e+08  2.17758418e+00  1.90546072e+08 -1.78340032e+02  1.90546072e+08  1.65773380e+00  1.90546072e+08 -8.60015353e+01  1.90546072e+08  8.19818378e+00  1.90546072e+08 -9.69487817e+01
 1.94984460e+08  2.17993510e+00  1.94984460e+08  2.17993569e+00  1.94984460e+08 -1.78388733e+02  1.94984460e+08  1.60898096e+00  1.94984460e+08 -8.57989796e+01  1.94984460e+08  8.20053531e+00  1.94984460e+08 -9.67465297e+01
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
