MacAnalog/dn-002-tx-driver-pam4-ihp130/layout/codesign/results/r4/best.png

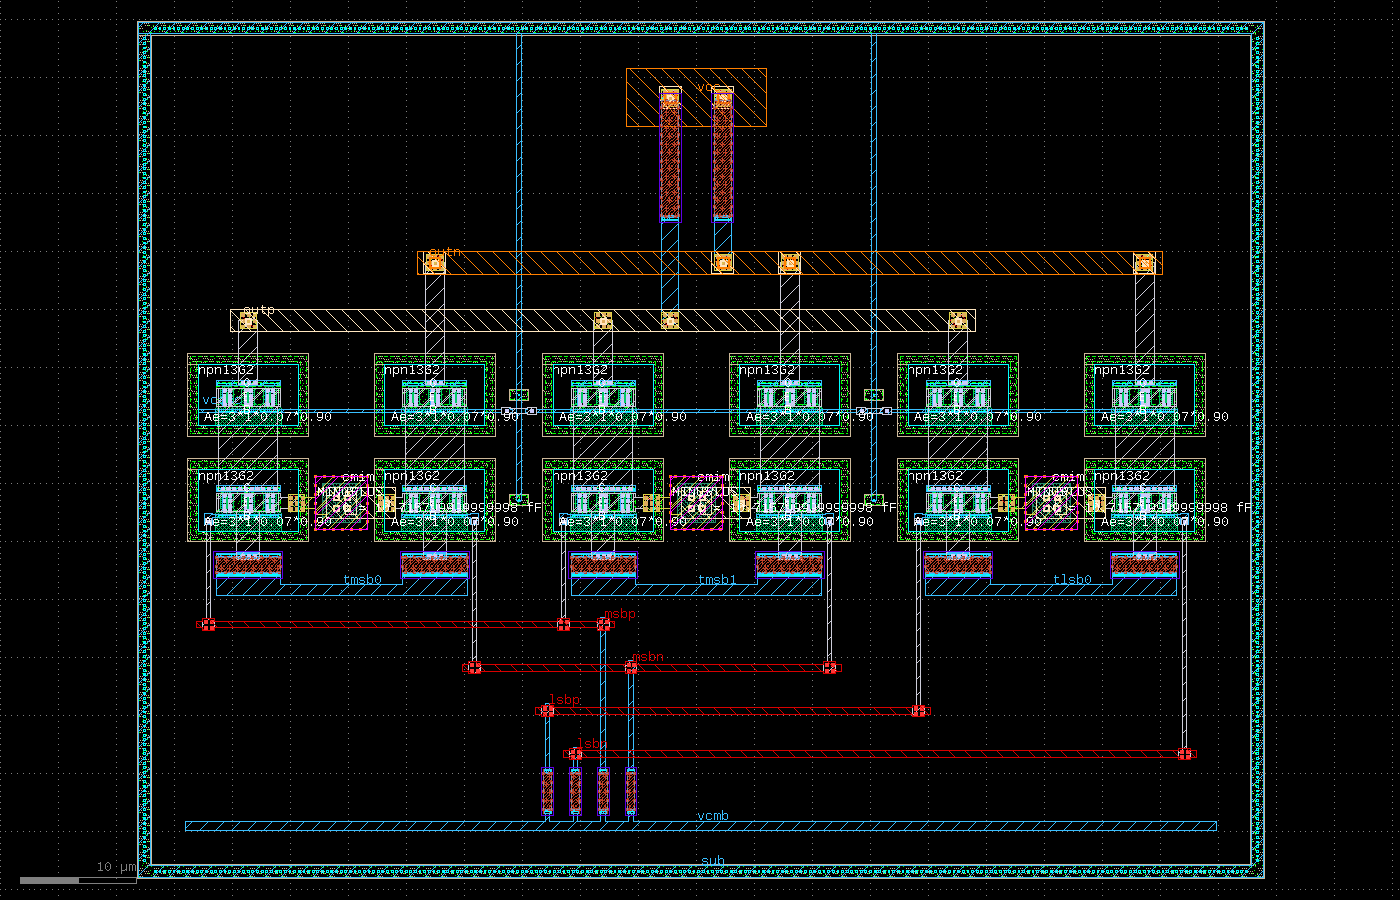
layout/codesign/results/r4/best.png
