MacAnalog/dn-002-tx-driver-pam4-ihp130/layout/codesign/results/r4/fig_pvt_r4.png

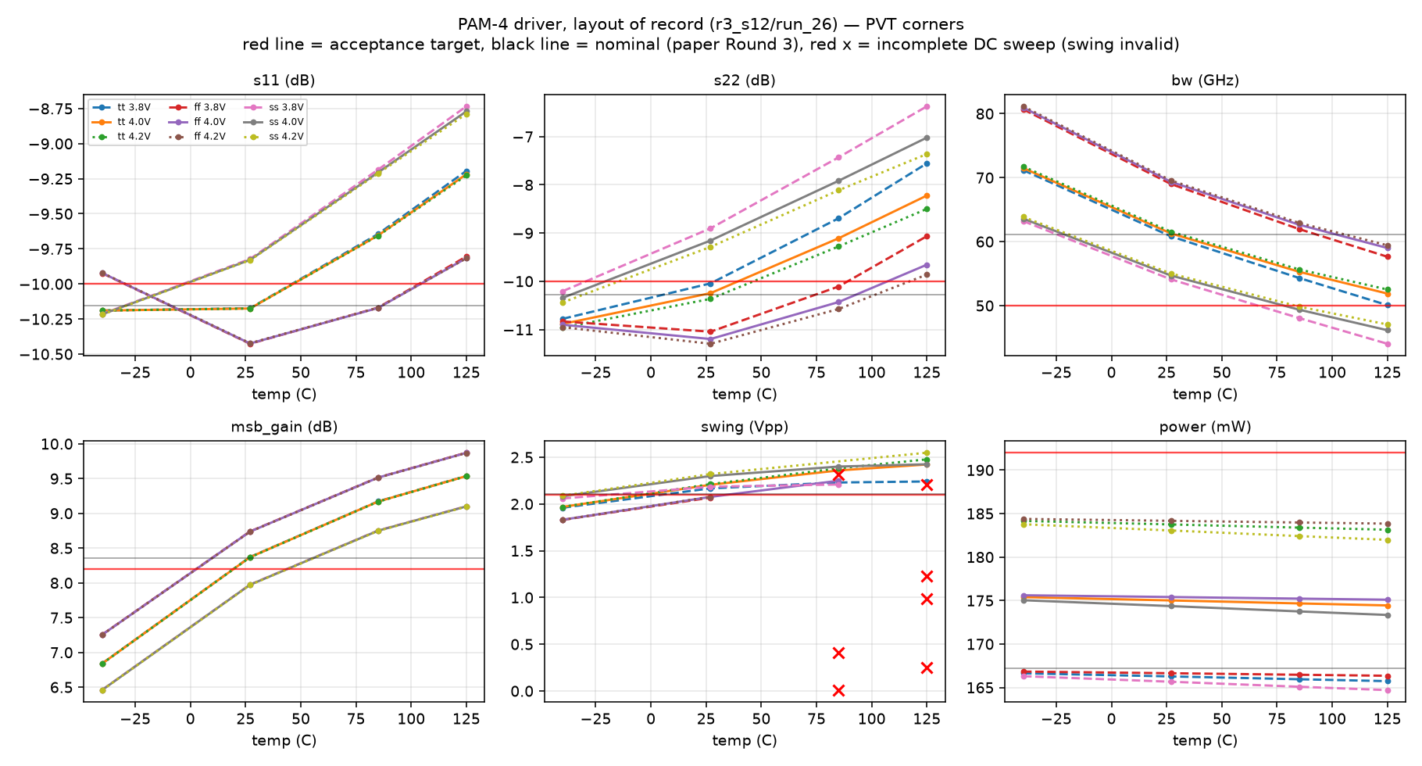
layout/codesign/results/r4/fig_pvt_r4.png
