MacAnalog/dn-002-tx-driver-pam4-ihp130/layout/codesign/pam4_layout_annotated_r4.pdf

30

40

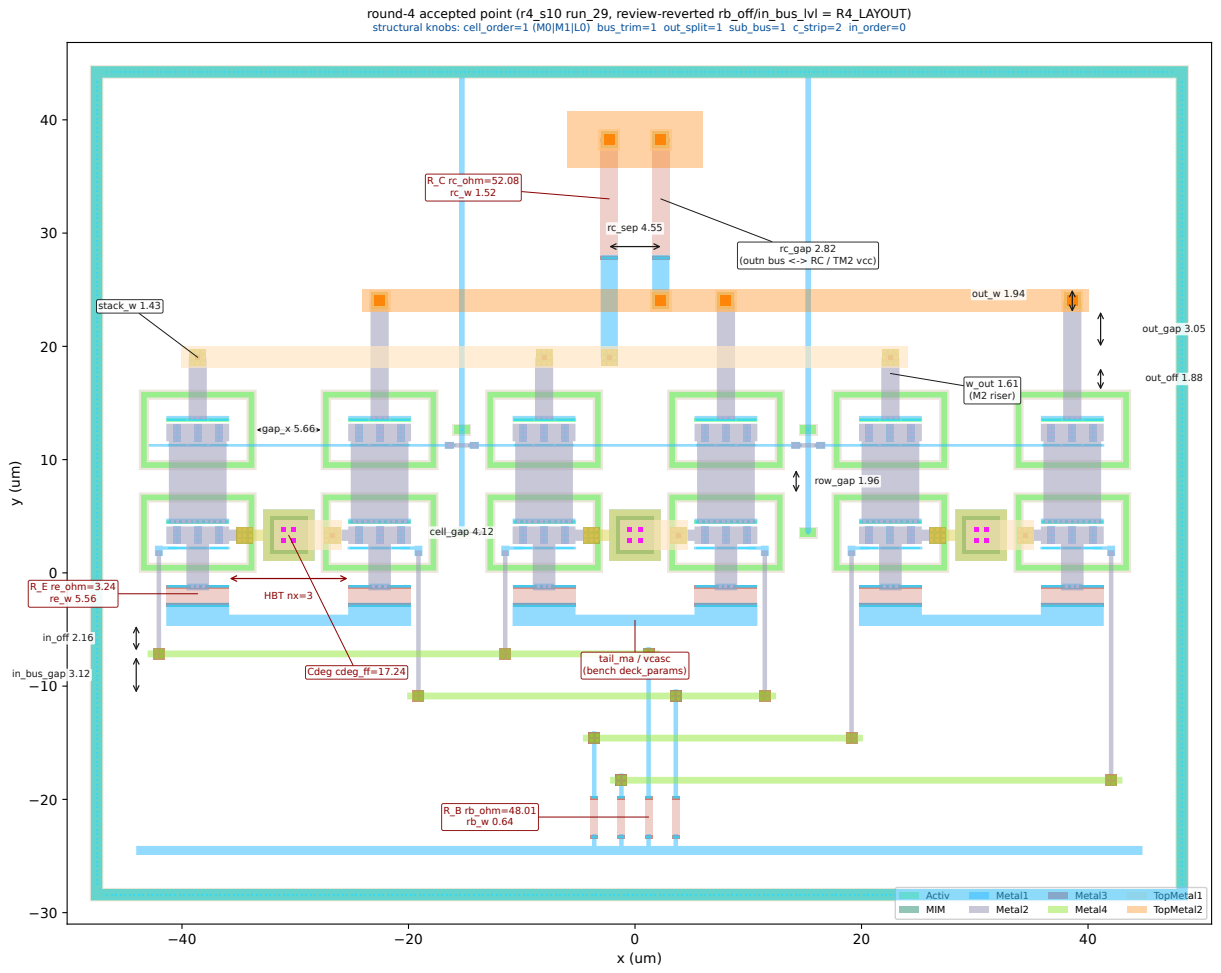
[picture p31: page 1]
Activ MIM; Metal1 Metal2; Metal3 Metal4; TopMetal1 TopMetal2; HBT nx=3; gap_x 5.66; cell_gap 4.12; row_gap 1.96; out_gap 3.05; out_w 1.94; out_off 1.88; rc_sep 4.55; rc_gap 2.82; R_C rc_ohm=52.08 rc_w 1.52; w_out 1.61 (M2 riser); stack_w 1.43; Cdeg cdeg_ff=17.24; R_E re_ohm=3.24 re_w 5.56; in_off 2.16; in_bus_gap 3.12; R_B rb_ohm=48.01 rb_w 0.64; tail_ma / vcasc (bench deck_params)

round-4 accepted point (r4_s10 run_29, review-reverted rb_off/in_bus_lvl = R4_LAYOUT)
structural knobs: cell_order=1 (M0|M1|L0) bus_trim=1 out_split=1 sub_bus=1 c_strip=2 in_order=0

(outn bus <-> RC / TM2 vcc)
