MacAnalog/dn-002-tx-driver-pam4-ihp130/report/figs/fig_layout_annotated_paper.pdf

30

40

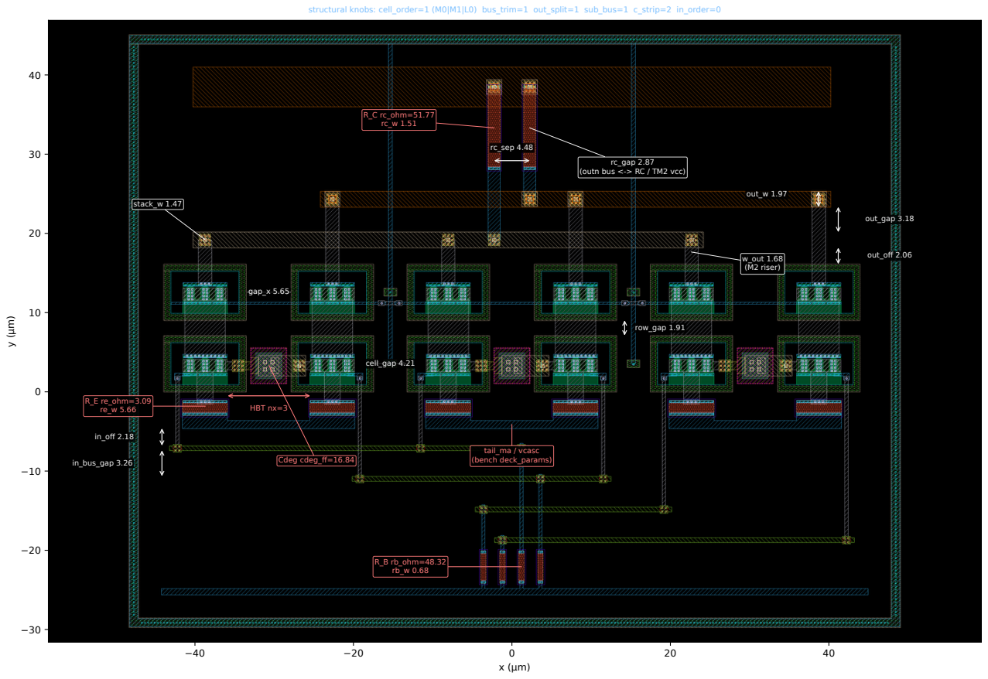
[picture p33: page 1]
structural knobs: cell_order=1 (M0|M1|L0) bus_trim=1 out_split=1 sub_bus=1 c_strip=2 in_order=0; HBT nx=3; gap_x 5.65; cell_gap 4.21; row_gap 1.91; out_gap 3.18; out_w 1.97; out_off 2.06; rc_sep 4.48; rc_gap 2.87; R_C rc_ohm=51.77 rc_w 1.51; w_out 1.68 (M2 riser); stack_w 1.47; Cdeg cdeg_ff=16.84; R_E re_ohm=3.09 re_w 5.66; in_off 2.18; in_bus_gap 3.26; R_B rb_ohm=48.32 rb_w 0.68; tail_ma / vcasc (bench deck_params)

(outn bus <-> RC / TM2 vcc)
