MacAnalog/dn-002-tx-driver-pam4-ihp130/verification/decks/f/s22_alg.spice

* TB[pam4] .op/ac S22 sweep (ngspice-45)
Vcc vcc 0 DC 4
Vcasc vcasc 0 DC 3.3427
Vcmb vcmb 0 DC 1.9
Vblsb blsb 0 DC 13.9958
Vbmsb bmsb 0 DC 13.9958
XDUT lsbp lsbn msbp msbn outp outn vcc vcasc vcmb blsb bmsb pam4drv_pam4
Vslsbp slsbp 0 DC 1.9
Vslsbn slsbn 0 DC 1.9
Rslsbp slsbp lsbp 50
Rslsbn slsbn lsbn 50
Vsmsbp smsbp 0 DC 1.9
Vsmsbn smsbn 0 DC 1.9
Rsmsbp smsbp msbp 50
Rsmsbn smsbn msbn 50
Vsop sop 0 DC 4 AC 0.5
Vson son 0 DC 4 AC -0.5
Rsop sop outp 50
Rson son outn 50
* post-layout adapter: pam4drv_pam4_lay -> pam4drv_pam4 schematic ports
.subckt pam4drv_pam4 lsbp lsbn msbp msbn outp outn vcc vcasc vcmb blsb bmsb
Xlay sub msbn lsbp vcmb lsbn msbp tmsb0 tmsb1 tlsb0 vcasc outp outn vcc pam4drv_pam4_lay
Gtlsb0 tlsb0 0 blsb 0 1m
Gtmsb0 tmsb0 0 bmsb 0 1m
Gtmsb1 tmsb1 0 bmsb 0 1m
Vsub sub 0 DC 0
.ends pam4drv_pam4
.include "../../../report/layout/f/dut_pam4_post.spice"
.lib "cornerRES.lib" res_typ
.lib "cornerCAP.lib" cap_typ

.lib "cornerHBT.lib" hbt_typ
.options gmin=1e-12 reltol=1e-3
.control
op
ac dec 100 1e+08 1e+11
let vodiff = v(outp)-v(outn)
let zout = vodiff*100/(1-vodiff)
let s22db = db((zout-100)/(zout+100))
wrdata s22_alg.csv s22db
.endc
.GLOBAL GND
.end
