MacAnalog/dn-002-tx-driver-pam4-ihp130/(commit log)

2026-09-01 PAM-4 Reviewer Delivery Package (#4)
    * align the repo to the paper: r3_s12/run_26 is the layout of record (tier f), CM->DM conversion + full-swing eye instruments, verification re-frozen
    - gen_layout.py: FINAL_LAYOUT/FINAL_BIASES = the paper's design of record r3_s12/run_26
    (round-3 best-score point, 167.2 mW); the previous v4 point is kept as V4_LAYOUT/V4_BIASES
    - report: new tier f (record); tiers a-f; CM->diff conversion A_cd = |Sdc21| from the same
    ngspice sp 4-port S-matrix as the balance bench; full-swing eye (900 mVpp, 10000 symbols,
    48 GBd) with per-eye width measurement; README results table restructured to the paper's
    columns (Sch/Lay/Round2/Round3)
    - verification: tier f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
    [balance.csv, balance_a.csv, balance_b.csv, balance_c.csv, balance_d.csv, balance_e.csv, balance_f.csv, dc.csv]
2026-09-03 co-design round 4: reviewer-margin hinges, vcc-rail trim; R4_LAYOUT = run_29 with the CM->diff-audit revert; PVT/MC/EM pack; report tier (g) (#6)
    * co-design round 4: reviewer-margin hinges + the vcc-rail trim and R_B slide from the extraction review; r4_s10/run_29 frozen as R4_LAYOUT
    What was done
    - project_setup.yaml (round 4): swing/gain/BW margins as hinges (2.2 Vpp, 8.3/2.3 dB, 55 GHz) + 2/dB MSB-gain reward on the unchanged r3 objective; in_order dropped; rounds/r4_*.yaml = the 13 islands (record / v4 / tail-bumped record, with and without the new options)
    - gen_layout.py: vcc_trim (TopMetal2 vcc rail trimmed to the RC stacks — the record drew it over the full bus extent, 64 um copl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
    [balance_g.csv, dc_g.csv, metrics.csv, sparams_g.csv]
2026-09-07 CLAUDE.md: simulation lanes by PDK + SpiceXplorer-first reuse (#7)
    * CLAUDE.md: simulation lanes by PDK (open → native; NDA → bridge only) + SpiceXplorer-first reuse, the contract for every agent
    Claude-Session: https://claude.ai/code/session_01EHXzwwUcUa6bAwFwpfimK4
    * CLAUDE.md: the schematic + report flow (xschem sheets for every cell and testbench via netlist2xschem, xvport for the commercial editor, findings as regenerated plots, experiments/NNN-* report shape)
    Claude-Session: https://claude.ai/code/session_01EHXzwwUcUa6bAwFwpfimK4
    ---------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
2026-09-07 CLAUDE.md: a declined /CMC prompt is never a stop — continue without the kit bytes (#8)
    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
2026-09-11 Codex review: the verification gate can no longer pass a run that simulated nothing (#11)
    * verification: a run that verified nothing must not exit 0 (DN2-01)
    verify.py could report a clean verification of a run in which nothing was
    simulated. Three independent holes, all of which turn "broken" into "green":
    * the return code of every `ngspice -b` was printed and then dropped. The deck
    CSVs are committed files, so a run whose decks all failed re-scored the
    PREVIOUS run's CSVs: reproduced with PDK_ROOT pointing at a non-existent tree
    — ten decks FAILED, "23/23 numbers reproduce within tolerance", exit 0. Each
    deck is now a check of its own, so a deck that did not run fails the run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
